RicardoScarvalho/Robota/Adesivo Robota/Adesivo Robota.png

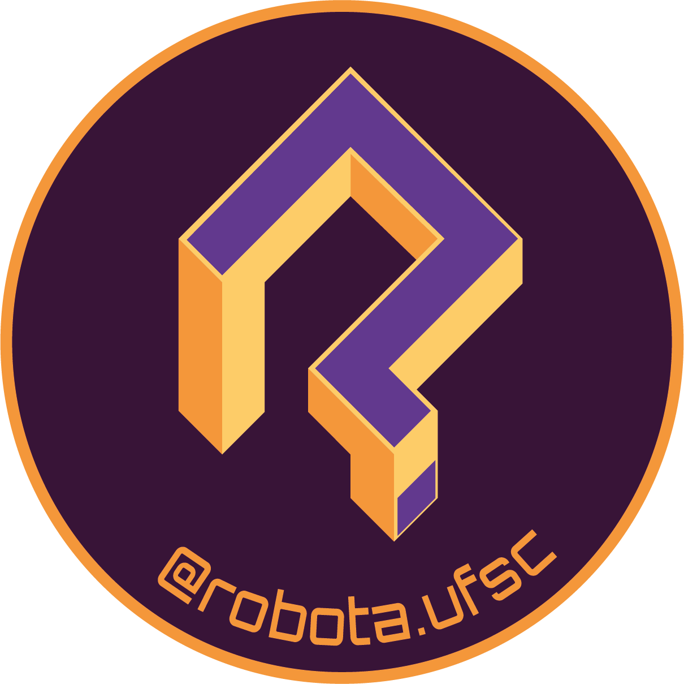
Adesivo Robota/Adesivo Robota.png
