RicardoScarvalho/Robota/Segue Linha/Sally/PCB/sensor_frontal/sensor_frontal.kicad_pcb

## KiCad design Segue Linha/Sally/PCB/sensor_frontal/sensor_frontal.kicad_pcb (2026-06-09)

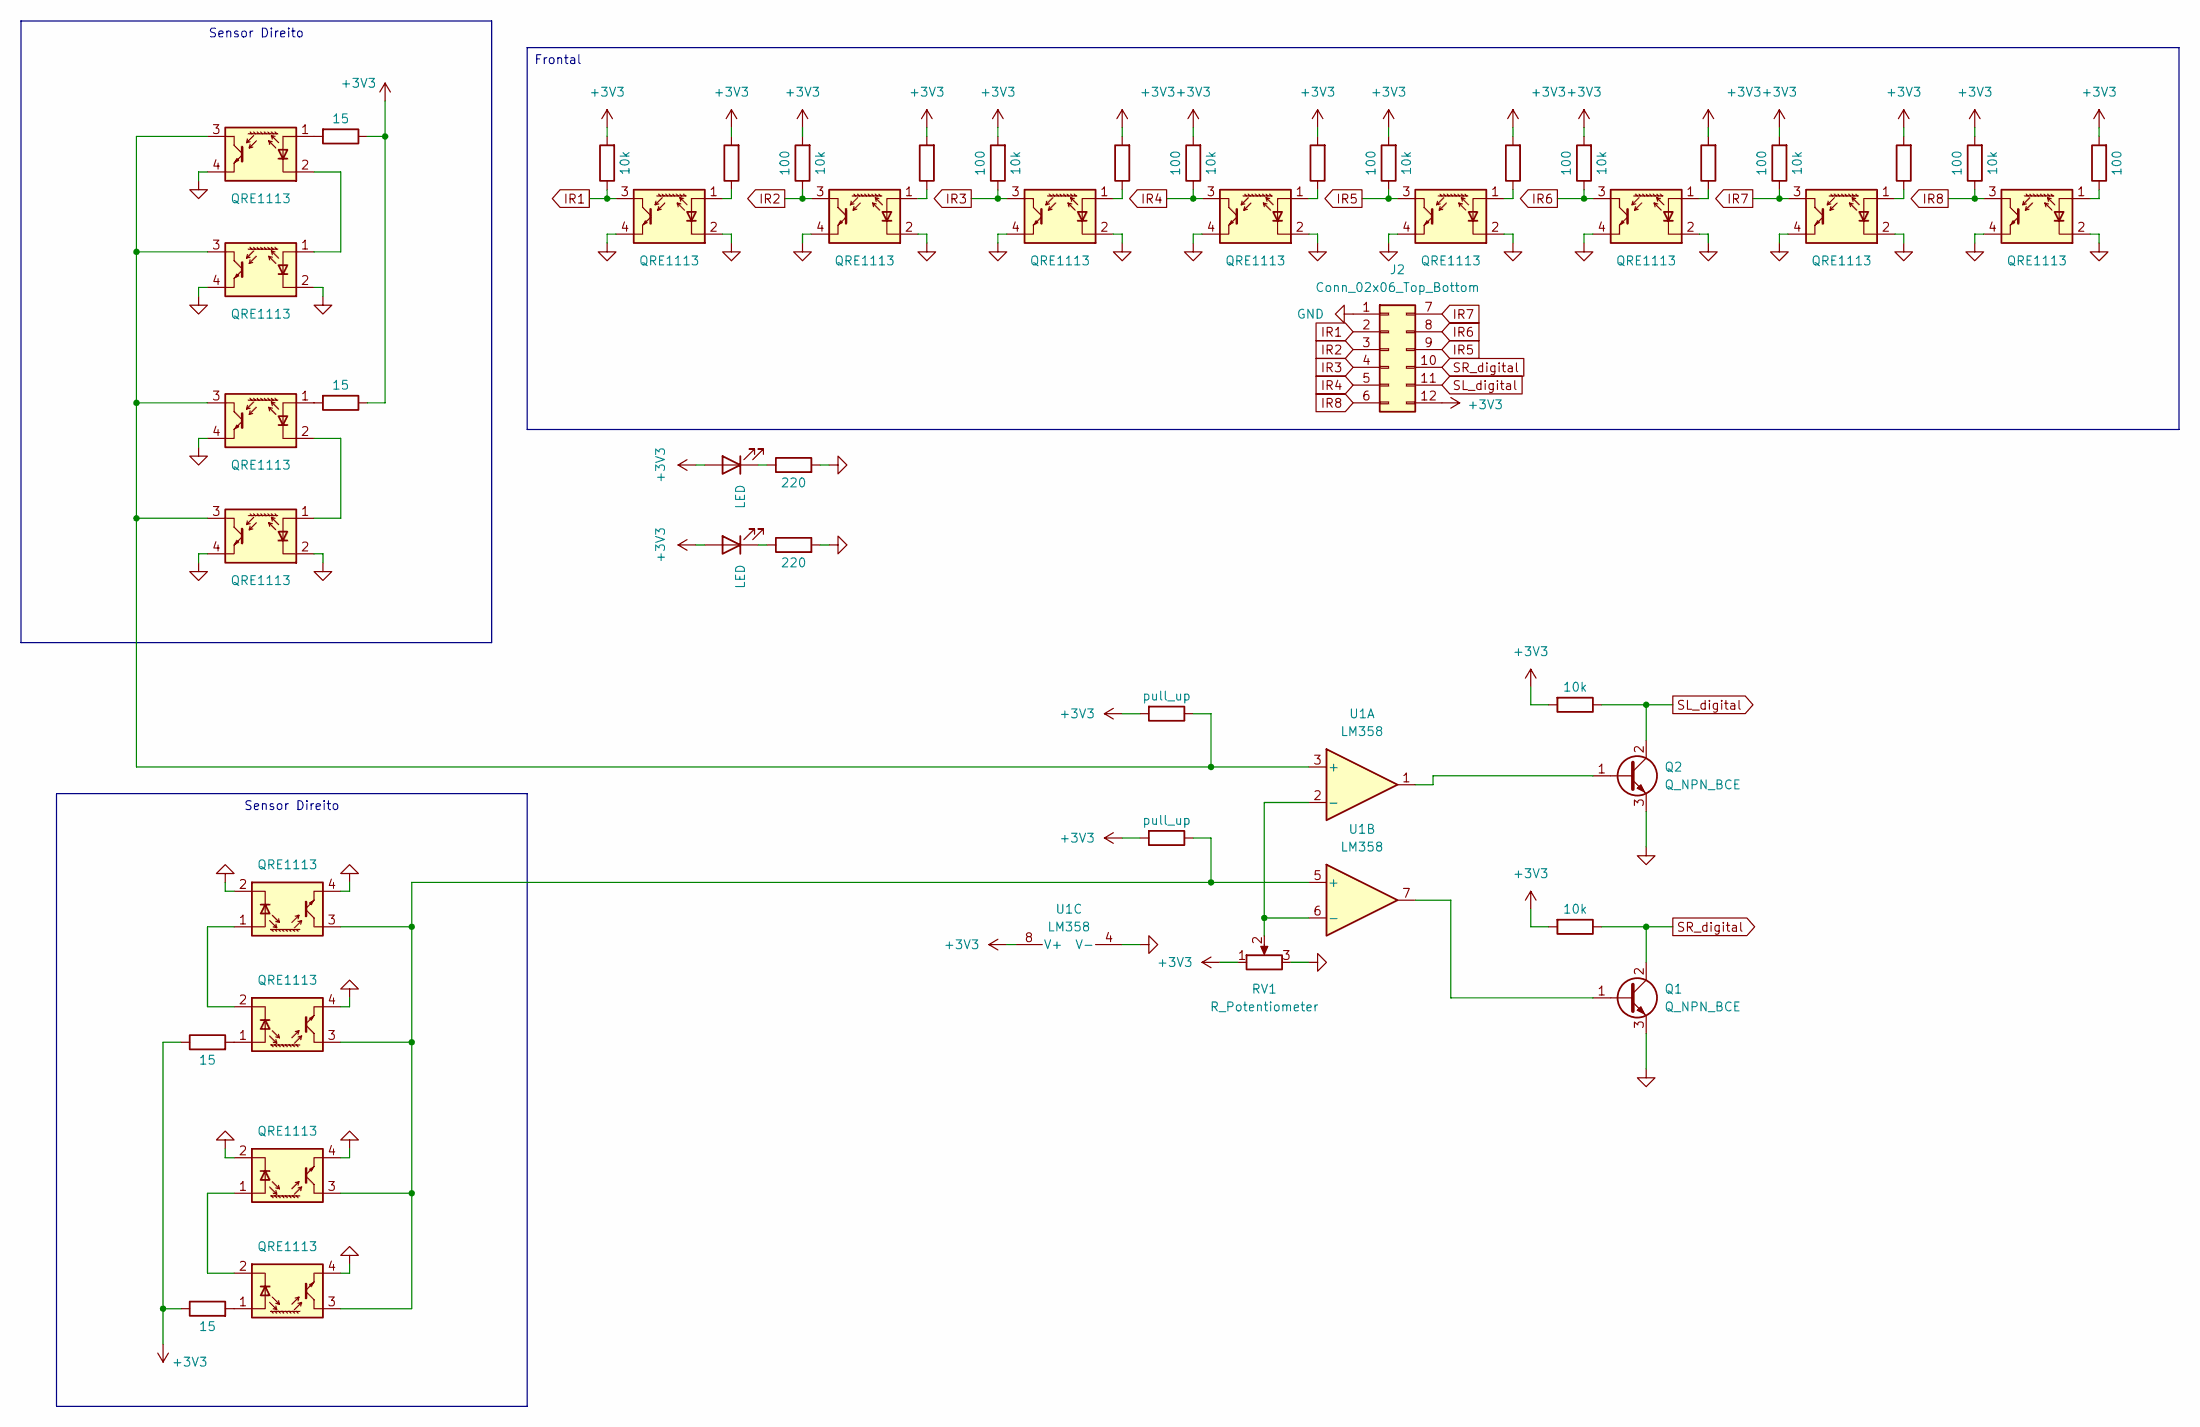
[picture p2: schematic sensor_frontal.kicad_sch]

Parts:
D4, D5: LED; LED_1206_3216Metric
J2: Conn_02x06_Top_Bottom; Hirose_FH12-12S-0.5SH_1x12-1MP_P0.50mm_Horizontal
Q1, Q2: Q_NPN_BCE; SOT-23
R11, R12, R29, R31, R32, R33, R34, R35, R44, R47: 10k; R_1206_3216Metric
R16, R18, R20, R21: 15; R_1206_3216Metric
R25, R26: 220; R_1206_3216Metric
R36, R37, R38, R39, R40, R41, R42, R43: 100; R_1206_3216Metric
R45, R46: pull_up; R_1206_3216Metric
RV1: R_Potentiometer; Potentiometer_Bourns_3314G_Vertical
U1: LM358; SOIC-8_3.9x4.9mm_P1.27mm
U5, U6, U7, U8, U11, U12, U13, U14, U15, U16, U17, U18, U19, U20, U21, U22: QRE1113; OnSemi_CASE100CY

Connections:
+3V3: D4.2 (A), D5.2 (A), J2.12, R11.2, R12.2, R16.1, R18.1, R20.1, R21.1, R29.2, R31.2, R32.2, R33.2, R34.2, R35.2, R36.2, R37.2, R38.2, R39.2, R40.2, R41.2, R42.2, R43.2, R44.2, R45.2, R46.2, R47.2, RV1.1, U1.8 (V+)
GND: J2.1, Q1.3 (E), Q2.3 (E), R25.2, R26.2, RV1.3, U1.4 (V-), U5.4, U6.2 (K), U6.4, U7.4, U8.2 (K), U8.4, U11.2 (K), U11.4, U12.4, U13.2 (K), U13.4, U14.4, U15.2 (K), U15.4, U16.2 (K), U16.4, U17.2 (K), U17.4, U18.2 (K), U18.4, U19.2 (K), U19.4, U20.2 (K), U20.4, U21.2 (K), U21.4, U22.2 (K), U22.4
IR1: J2.2, R11.1, U11.3
IR2: J2.3, R12.1, U16.3
IR3: J2.4, R29.1, U17.3
IR4: J2.5, R31.1, U18.3
IR5: J2.9, R32.1, U19.3
IR6: J2.8, R33.1, U20.3
IR7: J2.7, R34.1, U21.3
IR8: J2.6, R35.1, U22.3
unnamed: D4.1 (K), R25.1
unnamed: D5.1 (K), R26.1
unnamed: Q1.1 (B), U1.7
unnamed: Q2.1 (B), U1.1
unnamed: R45.1, U1.3 (+), U5.3, U6.3, U7.3, U8.3
unnamed: RV1.2, U1.2 (-), U1.6 (-)
unnamed: R46.1, U1.5 (+), U12.3, U13.3, U14.3, U15.3
unnamed: R18.2, U5.1 (A)
unnamed: U5.2 (K), U6.1 (A)
unnamed: R16.2, U7.1 (A)
unnamed: U7.2 (K), U8.1 (A)
unnamed: R36.1, U11.1 (A)
unnamed: R21.2, U12.1 (A)
unnamed: U12.2 (K), U13.1 (A)
unnamed: R20.2, U14.1 (A)
unnamed: U14.2 (K), U15.1 (A)
unnamed: R37.1, U16.1 (A)
unnamed: R38.1, U17.1 (A)
unnamed: R39.1, U18.1 (A)
unnamed: R40.1, U19.1 (A)
unnamed: R41.1, U20.1 (A)
unnamed: R42.1, U21.1 (A)
unnamed: R43.1, U22.1 (A)
SL_digital: J2.11, Q2.2 (C), R47.1
SR_digital: J2.10, Q1.2 (C), R44.1

Notes on the sheet:
Sensor Direito
Frontal

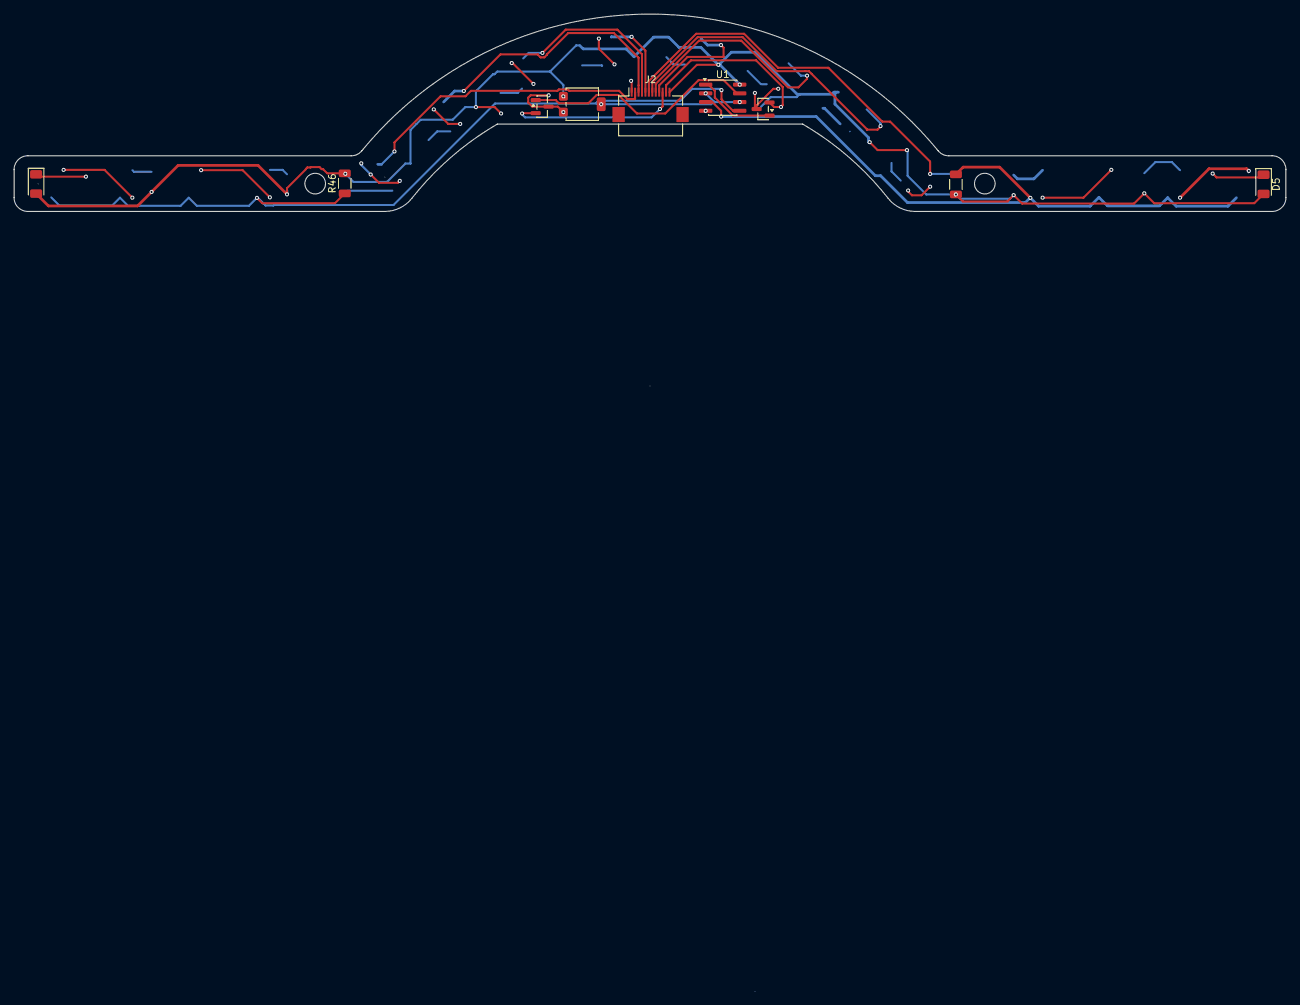
[picture p3: board sensor_frontal.kicad_pcb from above]

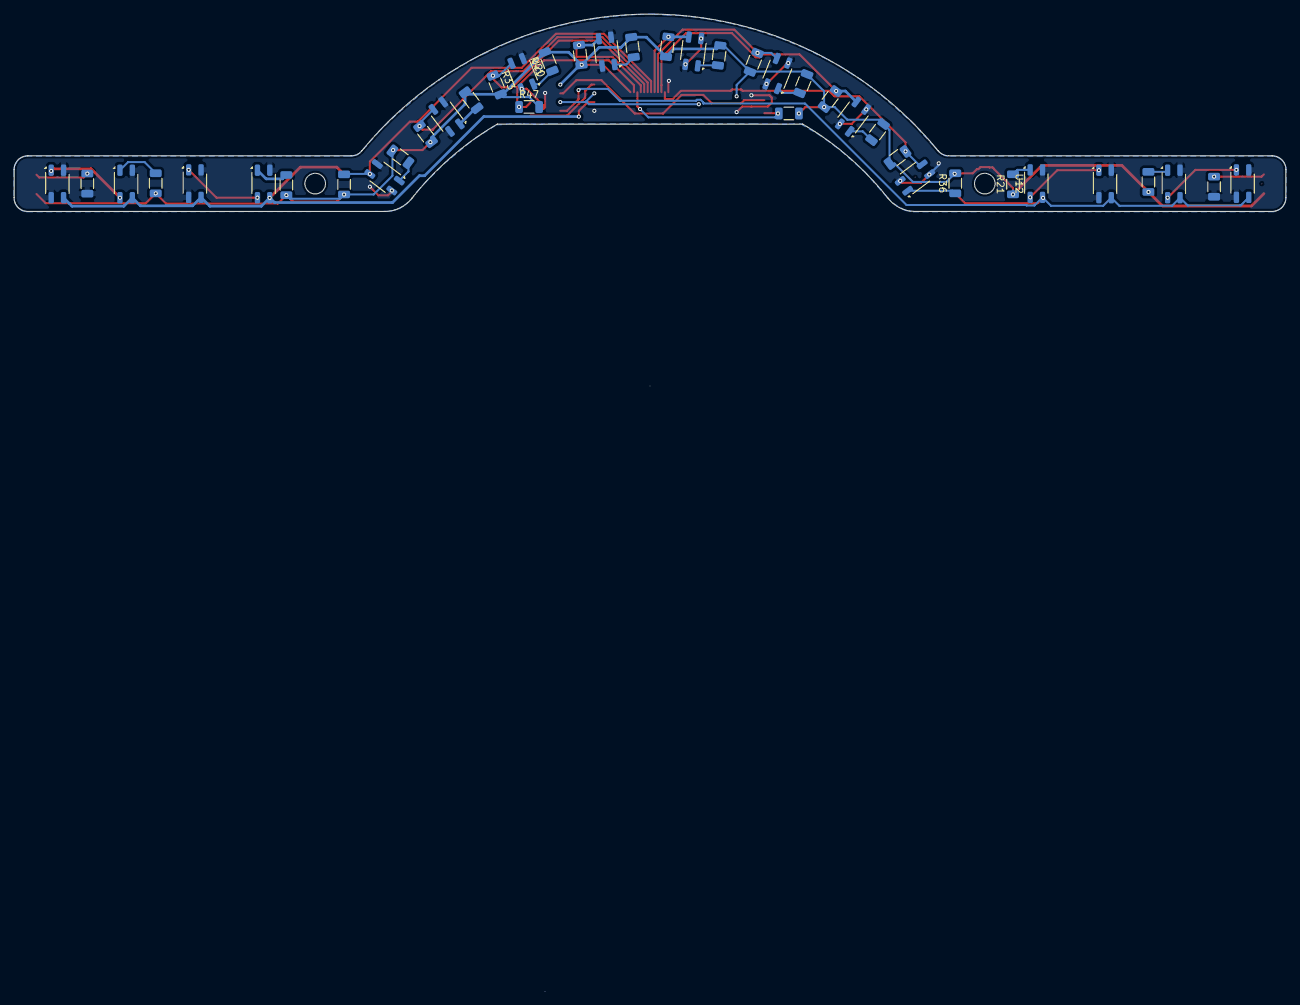
[picture p4: board sensor_frontal.kicad_pcb from below]

Board: 2 copper layers, 185.0 x 28.7 mm, 49 parts (40 on the bottom side), 35 nets.
