RicardoScarvalho/Robota/Segue Linha/Barry/pcb-seguidor-2024-alison/pcb-seguidor-2024/pcb-seguidor-2024.kicad_sch

## KiCad design Segue Linha/Barry/pcb-seguidor-2024-alison/pcb-seguidor-2024/pcb-seguidor-2024.kicad_sch (2026-06-09)

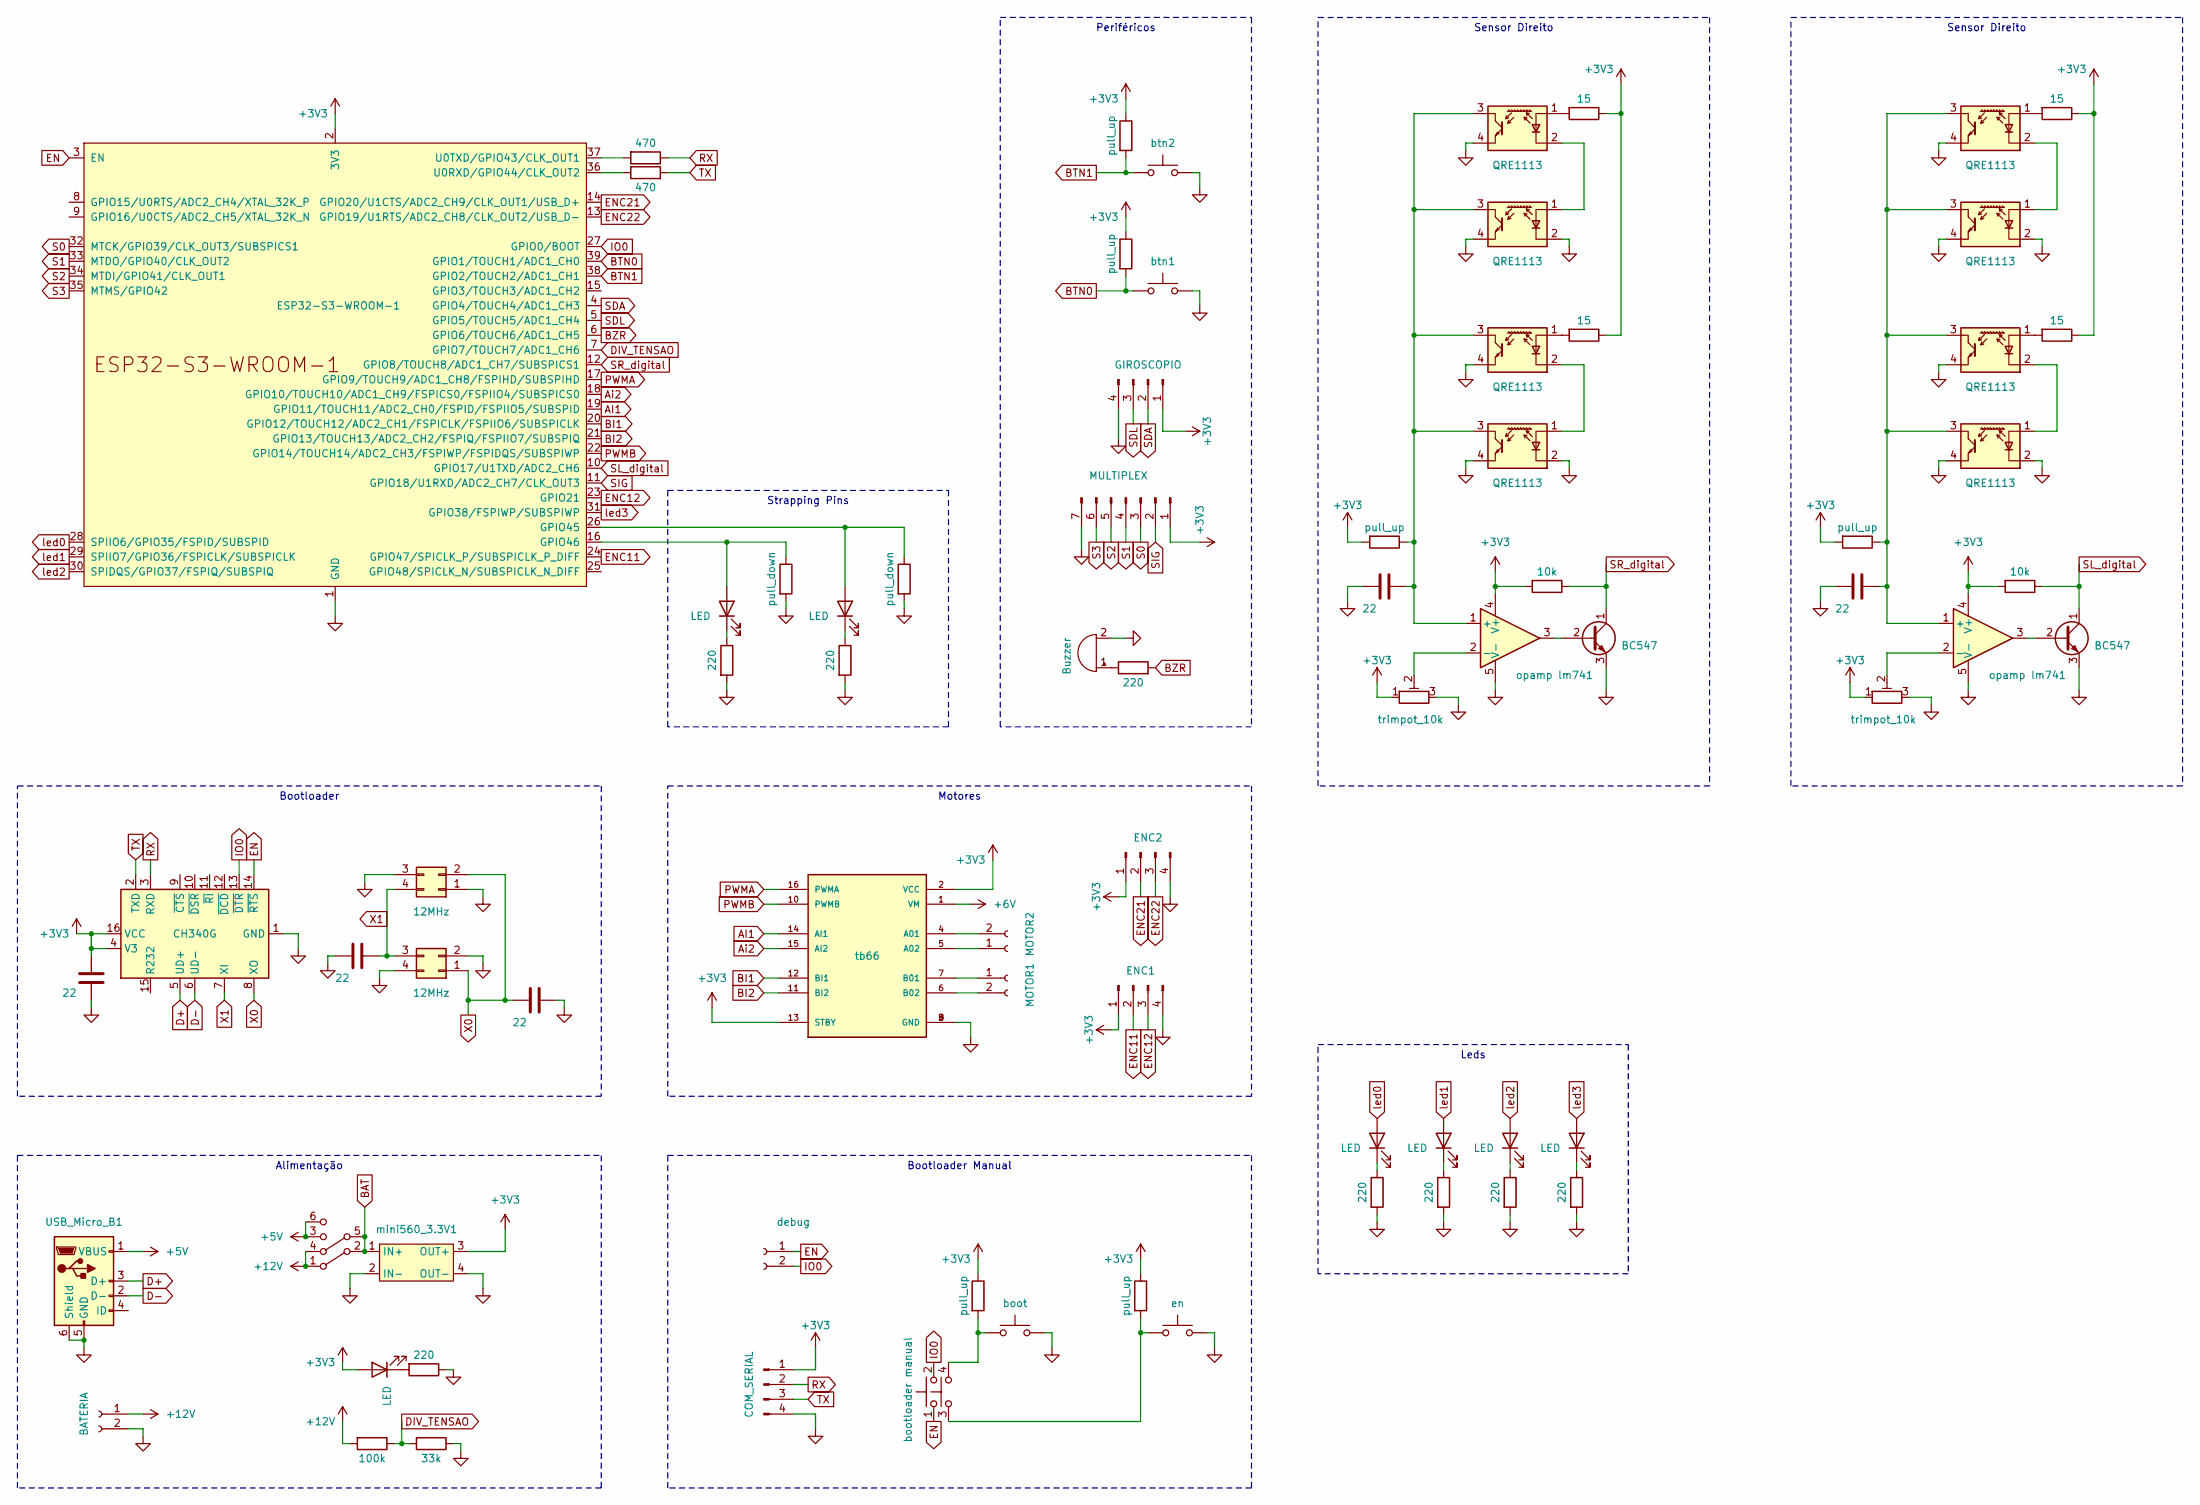
[picture p8: schematic pcb-seguidor-2024.kicad_sch]

Parts:
BZ1: Buzzer; Buzzer_12x9.5RM7.6
C1, C2, C3, C5, C6: 22; C_0603_1608Metric
Clock1, Clock2: 12MHz; XTAL_403WF12012IMR
D1, D2, D3, D4, D5, D6, D7: LED; LED_1206_3216Metric
Q1, Q2: BC547; TO-92_Inline
R1, R4, R6, R10, R25, R26, R27, R28: 220; R_1206_3216Metric
R2: 100k; R_1206_3216Metric
R3: 33k; R_1206_3216Metric
R5, R7: pull_down; R_1206_3216Metric
R8, R9, R11, R12, R14, R15: pull_up; R_1206_3216Metric
R13, R17: 10k; R_1206_3216Metric
R16, R18, R20, R21: 15; R_1206_3216Metric
R23, R24: 470; R_1206_3216Metric
RV1, RV2: trimpot_10k; Potentiometer_Vishay_T73YP_Vertical
SW1: boot; SW_PUSH_6mm
SW2: btn1; SW_PUSH_6mm
SW3: btn2; SW_PUSH_6mm
SW4: en; SW_PUSH_6mm
SW5: bootloader manual; SW_DIP_SPSTx02_Slide_9.78x7.26mm_W7.62mm_P2.54mm
SW6: SW_DPDT_x2; SW_CuK_JS202011AQN_DPDT_Angled
U1: ESP32-S3-WROOM-1
U2: opamp lm741; LM741
U5, U6, U7, U8, U12, U13, U14, U15: QRE1113; OnSemi_CASE100CY
U9: opamp lm741; DIP794W45P254L959H508Q8
U16: tb66; MODULE_ROB-14450; PARTREV 11-13-17
USB_Micro_B1: USB_B_Micro; USB_Micro-B_Molex-105017-0001
con1: BATERIA; Molex_KK-254_AE-6410-02A_1x02_P2.54mm_Vertical
con2: debug; Molex_KK-254_AE-6410-02A_1x02_P2.54mm_Vertical
con3: COM_SERIAL; Molex_KK-254_AE-6410-04A_1x04_P2.54mm_Vertical
con4: MOTOR2; Molex_KK-254_AE-6410-02A_1x02_P2.54mm_Vertical
con5: MOTOR1; Molex_KK-254_AE-6410-02A_1x02_P2.54mm_Vertical
con6: GIROSCOPIO; Molex_KK-254_AE-6410-04A_1x04_P2.54mm_Vertical
con7: MULTIPLEX; Molex_KK-254_AE-6410-07A_1x07_P2.54mm_Vertical
con8: ENC1; Molex_KK-254_AE-6410-04A_1x04_P2.54mm_Vertical
con10: ENC2; Molex_KK-254_AE-6410-04A_1x04_P2.54mm_Vertical
conversorTTL1: CH340G; SOIC-16_3.9x9.9mm_P1.27mm
mini560_3.3V1: mini560_3.3V

Connections:
+3V3: C1.1, D1.2 (A), R8.1, R9.1, R11.1, R12.1, R13.2, R14.2, R15.2, R16.1, R17.2, R18.1, R20.1, R21.1, RV1.1, RV2.1, U1.2 (3V3), U2.4 (V+), U9.4 (V+), U16.2 (VCC), U16.13 (STBY), con3.1, con6.1, con7.1, con8.1, con10.1, conversorTTL1.4 (V3), conversorTTL1.16 (VCC), mini560_3.3V1.3 (OUT+)
+5V: SW6.3 (C), SW6.6 (C), USB_Micro_B1.1 (VBUS)
+6V: U16.1 (VM)
+12V: R2.2, SW6.1 (A), SW6.4 (A), con1.1
AI1: U1.19 (GPIO11/TOUCH11/ADC2_CH0/FSPID/FSPIIO5/S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), U16.14 (AI1)
Ai2: U1.18 (GPIO10/TOUCH10/ADC1_CH9/FSPICS0/FSPIIO4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), U16.15 (AI2)
BAT: SW6.2 (B), SW6.5 (B), mini560_3.3V1.1 (IN+)
BI1: U1.20 (GPIO12/TOUCH12/ADC2_CH1/FSPICLK/FSPIIO6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), U16.12 (BI1)
BI2: U1.21 (GPIO13/TOUCH13/ADC2_CH2/FSPIQ/FSPIIO7/S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), U16.11 (BI2)
BTN0: R11.2, SW2.1, U1.39 (GPIO1/TOUCH1/ADC1_CH0)
BTN1: R12.2, SW3.1, U1.38 (GPIO2/TOUCH2/ADC1_CH1)
BZR: R10.2, U1.6 (GPIO6/TOUCH6/ADC1_CH5)
D+: USB_Micro_B1.3 (D+), conversorTTL1.5 (UD+)
D-: USB_Micro_B1.2 (D-), conversorTTL1.6 (UD-)
DIV_TENSAO: R2.1, R3.2, U1.7 (GPIO7/TOUCH7/ADC1_CH6)
EN: SW5.1 (C), U1.3 (EN), con2.1, conversorTTL1.14 (~RTS)
ENC11: U1.24 (GPIO47/SPICLK_P/SUBSPICLK_P_DIFF), con8.2
ENC12: U1.23 (GPIO21), con8.3
ENC21: U1.14 (GPIO20/U1CTS/ADC2_CH9/CLK_OUT1/USB_D+), con10.2
ENC22: U1.13 (GPIO19/U1RTS/ADC2_CH8/CLK_OUT2/USB_D-), con10.3
GND: BZ1.2 (+), C1.2, C2.1, C3.2, C5.1, C6.1, Clock1.2, Clock1.4, Clock2.1, Clock2.3, Q1.3 (E), Q2.3 (E), R1.1, R3.1, R4.2, R5.2, R6.2, R7.2, R25.2, R26.2, R27.2, R28.2, RV1.3, RV2.3, SW1.2, SW2.2, SW3.2, SW4.2, U1.1 (GND), U1.40 (GND), U1.41 (GND), U2.5 (V-), U5.4, U6.2 (K), U6.4, U7.4, U8.2 (K), U8.4, U9.5 (V-), U12.4, U13.2 (K), U13.4, U14.4, U15.2 (K), U15.4, U16.3 (GND), U16.8 (GND), U16.9 (GND), USB_Micro_B1.5 (GND), USB_Micro_B1.6 (Shield), con1.2, con3.4, con6.4, con7.7, con8.4, con10.4, conversorTTL1.1 (GND), mini560_3.3V1.2 (IN-), mini560_3.3V1.4 (OUT-)
IO0: SW5.2 (D), U1.27 (GPIO0/BOOT), con2.2, conversorTTL1.13 (~DTR)
unnamed: BZ1.1 (-), R10.1
unnamed: C5.2, R14.1, U2.1 (+), U5.3, U6.3, U7.3, U8.3
unnamed: C6.2, R15.1, U9.1 (+), U12.3, U13.3, U14.3, U15.3
unnamed: D1.1 (K), R1.2
unnamed: D2.1 (K), R4.1
unnamed: D2.2 (A), R5.1, U1.16 (GPIO46)
unnamed: D3.1 (K), R6.1
unnamed: D3.2 (A), R7.1, U1.26 (GPIO45)
unnamed: D4.1 (K), R25.1
unnamed: D5.1 (K), R26.1
unnamed: D6.1 (K), R27.1
unnamed: D7.1 (K), R28.1
unnamed: Q1.2 (B), U2.3
unnamed: Q2.2 (B), U9.3
unnamed: R8.2, SW1.1, SW5.4 (D)
unnamed: R9.2, SW4.1, SW5.3 (C)
unnamed: R16.2, U7.1 (A)
unnamed: R18.2, U5.1 (A)
unnamed: R20.2, U14.1 (A)
unnamed: R21.2, U12.1 (A)
unnamed: R23.2, U1.37 (U0TXD/GPIO43/CLK_OUT1)
unnamed: R24.1, U1.36 (U0RXD/GPIO44/CLK_OUT2)
unnamed: RV1.2, U2.2 (-)
unnamed: RV2.2, U9.2 (-)
unnamed: U5.2 (K), U6.1 (A)
unnamed: U7.2 (K), U8.1 (A)
unnamed: U12.2 (K), U13.1 (A)
unnamed: U14.2 (K), U15.1 (A)
unnamed: U16.4 (A01), con4.2
unnamed: U16.5 (A02), con4.1
unnamed: U16.6 (B02), con5.2
unnamed: U16.7 (B01), con5.1
PWMA: U1.17 (GPIO9/TOUCH9/ADC1_CH8/FSPIHD/SUBSPIHD), U16.16 (PWMA)
PWMB: U1.22 (GPIO14/TOUCH14/ADC2_CH3/FSPIWP/FSPIDQS/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), U16.10 (PWMB)
RX: R23.1, con3.2, conversorTTL1.3 (RXD)
S0: U1.32 (MTCK/GPIO39/CLK_OUT3/SUBSPICS1), con7.3
S1: U1.33 (MTDO/GPIO40/CLK_OUT2), con7.4
S2: U1.34 (MTDI/GPIO41/CLK_OUT1), con7.5
S3: U1.35 (MTMS/GPIO42), con7.6
SDA: U1.4 (GPIO4/TOUCH4/ADC1_CH3), con6.2
SDL: U1.5 (GPIO5/TOUCH5/ADC1_CH4), con6.3
SIG: U1.11 (GPIO18/U1RXD/ADC2_CH7/CLK_OUT3), con7.2
SL_digital: Q2.1 (C), R17.1, U1.10 (GPIO17/U1TXD/ADC2_CH6)
SR_digital: Q1.1 (C), R13.1, U1.12 (GPIO8/TOUCH8/ADC1_CH7/SUBSPICS1)
TX: R24.2, con3.3, conversorTTL1.2 (TXD)
X0: C3.1, Clock1.1, Clock2.2, conversorTTL1.8 (XO)
X1: C2.2, Clock1.3, Clock2.4, conversorTTL1.7 (XI)
led0: D4.2 (A), U1.28 (SPIIO6/GPIO35/FSPID/SUBSPID)
led1: D5.2 (A), U1.29 (SPIIO7/GPIO36/FSPICLK/SUBSPICLK)
led2: D6.2 (A), U1.30 (SPIDQS/GPIO37/FSPIQ/SUBSPIQ)
led3: D7.2 (A), U1.31 (GPIO38/FSPIWP/SUBSPIWP)

Notes on the sheet:
Alimentação
Sensor Direito
Motores
Periféricos
Bootloader Manual
Leds
Strapping Pins
Bootloader
